bhrugusetlur-art/cpu-design/openroad/README.md

# OpenROAD Sky130 hardening

This directory configures an initial standard-cell hardening run of
`design/cpu_top.v` with OpenROAD Flow Scripts (ORFS) and the `sky130hd`
platform. It produces a routed **core-block GDSII**, not a complete packaged
chip or shuttle-ready padframe. For the concise project overview and complete
simulation coverage, see the [main README](../README.md) and
[testing guide](../docs/testing.md).

## Prerequisites

- A Linux environment (native Linux, WSL2, or Docker Desktop)
- GNU Make and Git
- A current clone of OpenROAD Flow Scripts

On Windows, install WSL2 with Ubuntu first. Administrator permission and a
reboot can be required when the WSL optional features are initially enabled.

## Run

From a Linux shell:

```bash
git clone --recursive \
  https://github.com/The-OpenROAD-Project/OpenROAD-flow-scripts.git \
  "$HOME/OpenROAD-flow-scripts"

cd /path/to/cpu-design

make --file="$HOME/OpenROAD-flow-scripts/flow/Makefile" \
  DESIGN_CONFIG="$(pwd)/openroad/config.mk"
```

When using the official ORFS Docker image, run the same `make` invocation
through ORFS's `flow/util/docker_shell` helper and ensure this repository is
mounted into the container.

Generated logs, reports, databases, netlists, and GDS files are written below
`openroad/work/`. The final layout is located at:

```text
openroad/work/results/sky130hd/cpu8/base/6_final.gds
```

`openroad/work/` is intentionally ignored by Git because it is several
gigabytes. Back it up separately if the generated databases, reports, and GDS
must be preserved; the tracked RTL/configuration can reproduce the flow but is
not a backup of the generated layout.

## 2026-07-17 result

ORFS completed synthesis, floorplan, placement, CTS, routing, extraction, and
GDS stream-out for the `cpu_top` core using the official
`openroad/orfs:latest` image.

- Final GDS: `openroad/work/results/sky130hd/cpu8/base/6_final.gds`
- GDS size: 34,672,628 bytes
- SHA-256: `EB8056AF757277F4828EB0E29479399363749B9FE188F15C5EBE53F8C93879CD`
- Die: 1,094.220 um x 1,094.220 um; final design utilization: about 19%
- Constraint: 10 MHz (100 ns); final worst setup slack: 90.29 ns
- Estimated minimum period: 9.71 ns (102.96 MHz)
- Final setup, hold, max-slew, and max-capacitance violations: 0
- OpenROAD detailed-route DRC and antenna violations: 0
- Standalone KLayout Sky130 DRC markers: 0
- Project-deck KLayout 0.30.7 electrical LVS: clean; 146 circuit pairs,
  0 nonmatches
- VDD/VSS connectivity: connected; estimated power: 3.70 mW; worst reported
  IR drop: about 0.000015 V

The generated KLayout technology file initially contained a stale
`/workspace/.../klayout_tech.lef` path while the Docker helper mounted this
repository at `/work`. That caused the first GDS stream-out to omit 138,398
default-via references. Correcting the generated path to `/work/...`, rerunning
`do-gds-merged`, and copying `6_1_merged.gds` to `6_final.gds` produced the
via-complete GDS identified by the hash above. A future run must check
`6_1_merge.log` for `Invalid via name` warnings before accepting its GDS.

## 2026-07-18 electrical LVS result

The tracked `openroad/sky130hd_lvs.lylvs` deck now produces a clean electrical
comparison against the via-complete final GDS. The exact KLayout 0.30.7 run
completed in 1,047 seconds and wrote the Git-ignored evidence database to
`openroad/work/results/sky130hd/cpu8/base/patched5.lvsdb`:

```text
INFO : Congratulations! Netlists match.
CIRCUIT_PAIRS=146 NONMATCHES=0
```

The upstream deck required four project-specific corrections:

1. ORFS writes top-level port rectangles on pin-purpose datatype 16. The deck
   now connects those shapes to routed metal and datatype-5 text before
   promoting named top-level nets to pins.
2. `sky130_fd_sc_hd__conb_1` uses direct metal shorts in layout but zero-ohm
   resistors in CDL; the deck normalizes those two CDL connections.
3. Four used standard-cell variants contain split symmetric source/drain nodes.
   Targeted `join_symmetric_nets` passes normalize those cells; `a211oi_4`
   requires two passes because its split branches are nested.
4. Device-less tap cells are discarded during hierarchy alignment, so the deck
   explicitly restores their physical top-level `VNB`-to-`VSS` substrate tie.

A direct GDS geometry audit independently found all 82 text labels overlapping
datatype-16 pin geometry: 77 on met2, 3 on met3, and 2 on met5. There are 81
unique electrical top pins because the constant-low cell intentionally shorts
`halt` to `VSS`. Reloading the saved LVS database and invoking KLayout's optional
`flag_missing_ports` helper still reports combined-name aliases (`VNB` on the
ground net and `_UNCONNECTED_0` on VDD); the electrical cross-reference itself
has no unmatched circuits or pins, and the direct label-to-pin audit is clean.

This is open-source project-deck verification, not qualified foundry signoff.
The selected shuttle/foundry must rerun its own DRC/LVS decks before fabrication.

## Current limitations

- `cpu_top` is hardened as a core with debug ports; it has no I/O pad cells,
  package, ESD protection, or shuttle harness.
- `imem.v` uses `$readmemh("program.mem")`. The selected program is therefore
  fixed during synthesis and must be treated as a mask/standard-cell ROM for
  an ASIC, or replaced with a loadable memory architecture.
- `dmem.v` uses an `initial` block for the identity page table. That power-up
  behavior is not a reliable ASIC boot mechanism and must be replaced before
  tapeout.
- The inferred instruction memory, data memory, and cache arrays may be built
  from standard cells. Production hardening should evaluate compatible SRAM
  macros and adapt the memory interfaces where necessary.
- Final tapeout still requires a selected shuttle/foundry harness, padframe,
  qualified foundry signoff decks, and packaging decisions.
