bhrugusetlur-art/cpu-design/(commit log)

2026-07-06 Add FPGA register debug LEDs and saved zero flag for JZ
2026-07-10 feat: wire virtual memory into CPU top
2026-07-10 fix: stop L1 re-issuing L2 requests while awaiting response
    L1's per-byte writeback/fill loops re-strobed l2_re/l2_we whenever
    !re && !ready, which duplicates the request while L2 is busy. L2
    latched the duplicate after finishing the real one, shifting every
    later response by one byte, so cold fills stored byte N-1's data at
    offset N. Track one outstanding request with l2_pend instead.
    Exposed by MMU page-table walks reading PTE bytes at varied offsets.
    [cache_hierarchy_tb.v, l1_cache.v]
2026-07-10 test: strengthen VM flush proof and fail hierarchy tb loudly
    Preload VPN 2 via an identity-mapped store before rewriting its PTE
    so the CPU-level test fails if the PTE-store TLB flush is removed
    (verified by mutation). Count failures in cache_hierarchy_tb and
    exit via $fatal so regressions break the run.
    [cache_hierarchy_tb.v, cpu_vm_tb.v]
2026-07-18 Add Sky130 OpenROAD core hardening flow
2026-07-18 test: fail testbenches loudly and add make test runner
    [alu_tb.v, control_tb.v, cpu_top_tb.v, datapath_tb.v, dmem_tb.v, imem_tb.v, l1_cache_tb.v, l2_cache_tb.v]
2026-07-18 docs: track CLAUDE.md and prune stale gitignore entries
2026-09-15 docs(agents): record that the CPU ran on a Basys 3 board
2026-09-15 docs: record that the CPU ran on a physical Basys3 board
    Updates the README status and build story and the FPGA guide intro to say
    the design ran on a Basys3 board. The FPGA animation captions still note
    that the GIF is simulation-derived.
